vitaliyrenkas-rgb/ESP32-Li-ion-Battery-Capacity-Tester-DIY/(commit log)

2026-09-05 Fix duplicate note in README
    Removed duplicate note about firmware version and device identification.
2026-09-05 Update README with battery safety information
    Added important battery usage warnings and disclaimers to README.
2026-09-05 Revise battery disclaimer for better understanding
    Updated battery disclaimer for clarity and emphasis.
2026-09-05 Update battery warnings in README.md
    Clarified battery handling instructions and potential risks.
2026-09-05 Update battery warning in README
    Added warning about battery discharge risk due to lack of BMS.
2026-09-05 Update battery warning in README
    Clarified warning about battery discharge risks due to modifications.
2026-09-05 Update battery discharge warning in README
    Clarified warning about battery discharge during long storage.
2026-09-05 Update battery warning section in README
2026-09-05 Modify START button description in README
    Updated the description of the START button functionality to include 'STOP'.
