vitaliyrenkas-rgb/ESP32-Li-ion-Battery-Capacity-Tester-DIY/Photos/rt004-front.jpg

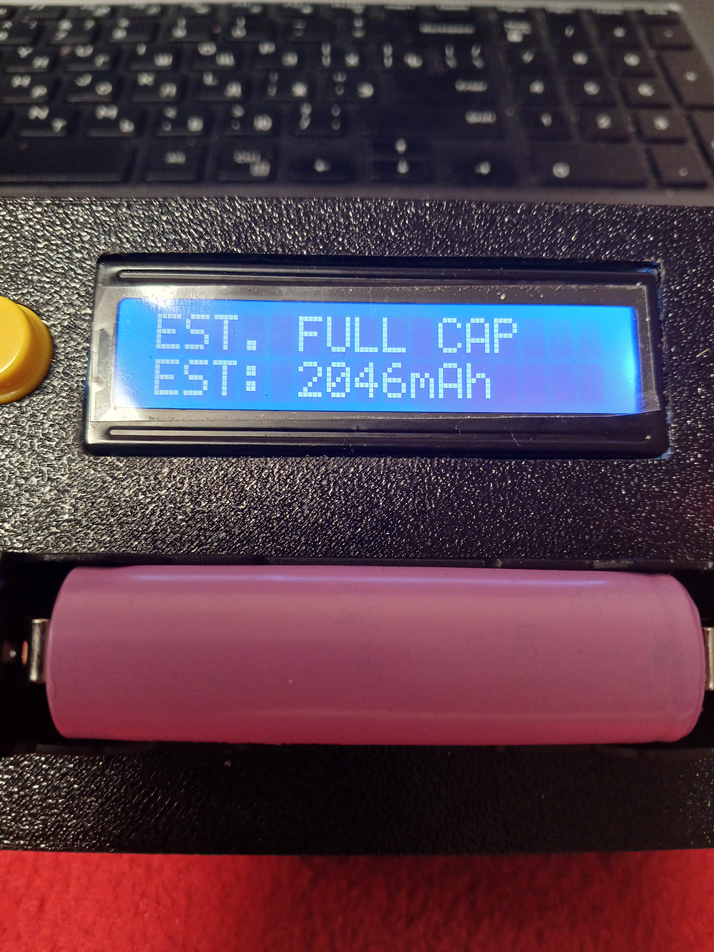
[picture p2: Photos/rt004-front.jpg]
Photos/rt004-front.jpg
