vitaliyrenkas-rgb/ESP32-Li-ion-Battery-Capacity-Tester-DIY/Photos/rt004-interior.jpg

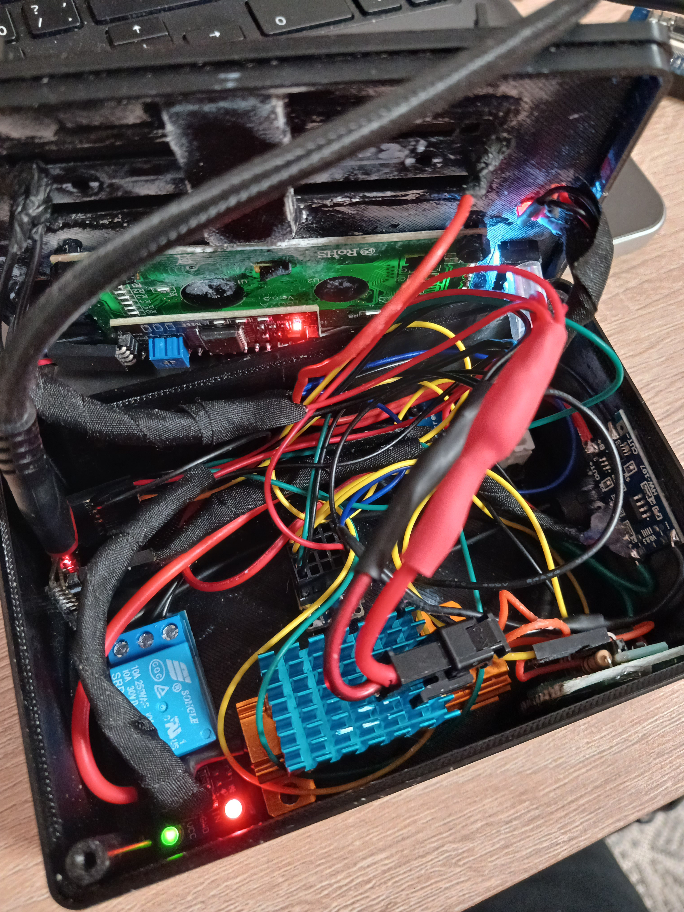
[picture p7: Photos/rt004-interior.jpg]
Photos/rt004-interior.jpg
